rayan4444/HAX_EE_demo/ATMEGA32u4 Breakout/ATMEGA32u4_Breakout_rev1.brd

## EAGLE design ATMEGA32u4 Breakout/ATMEGA32u4_Breakout_rev1.brd (2019-09-18)

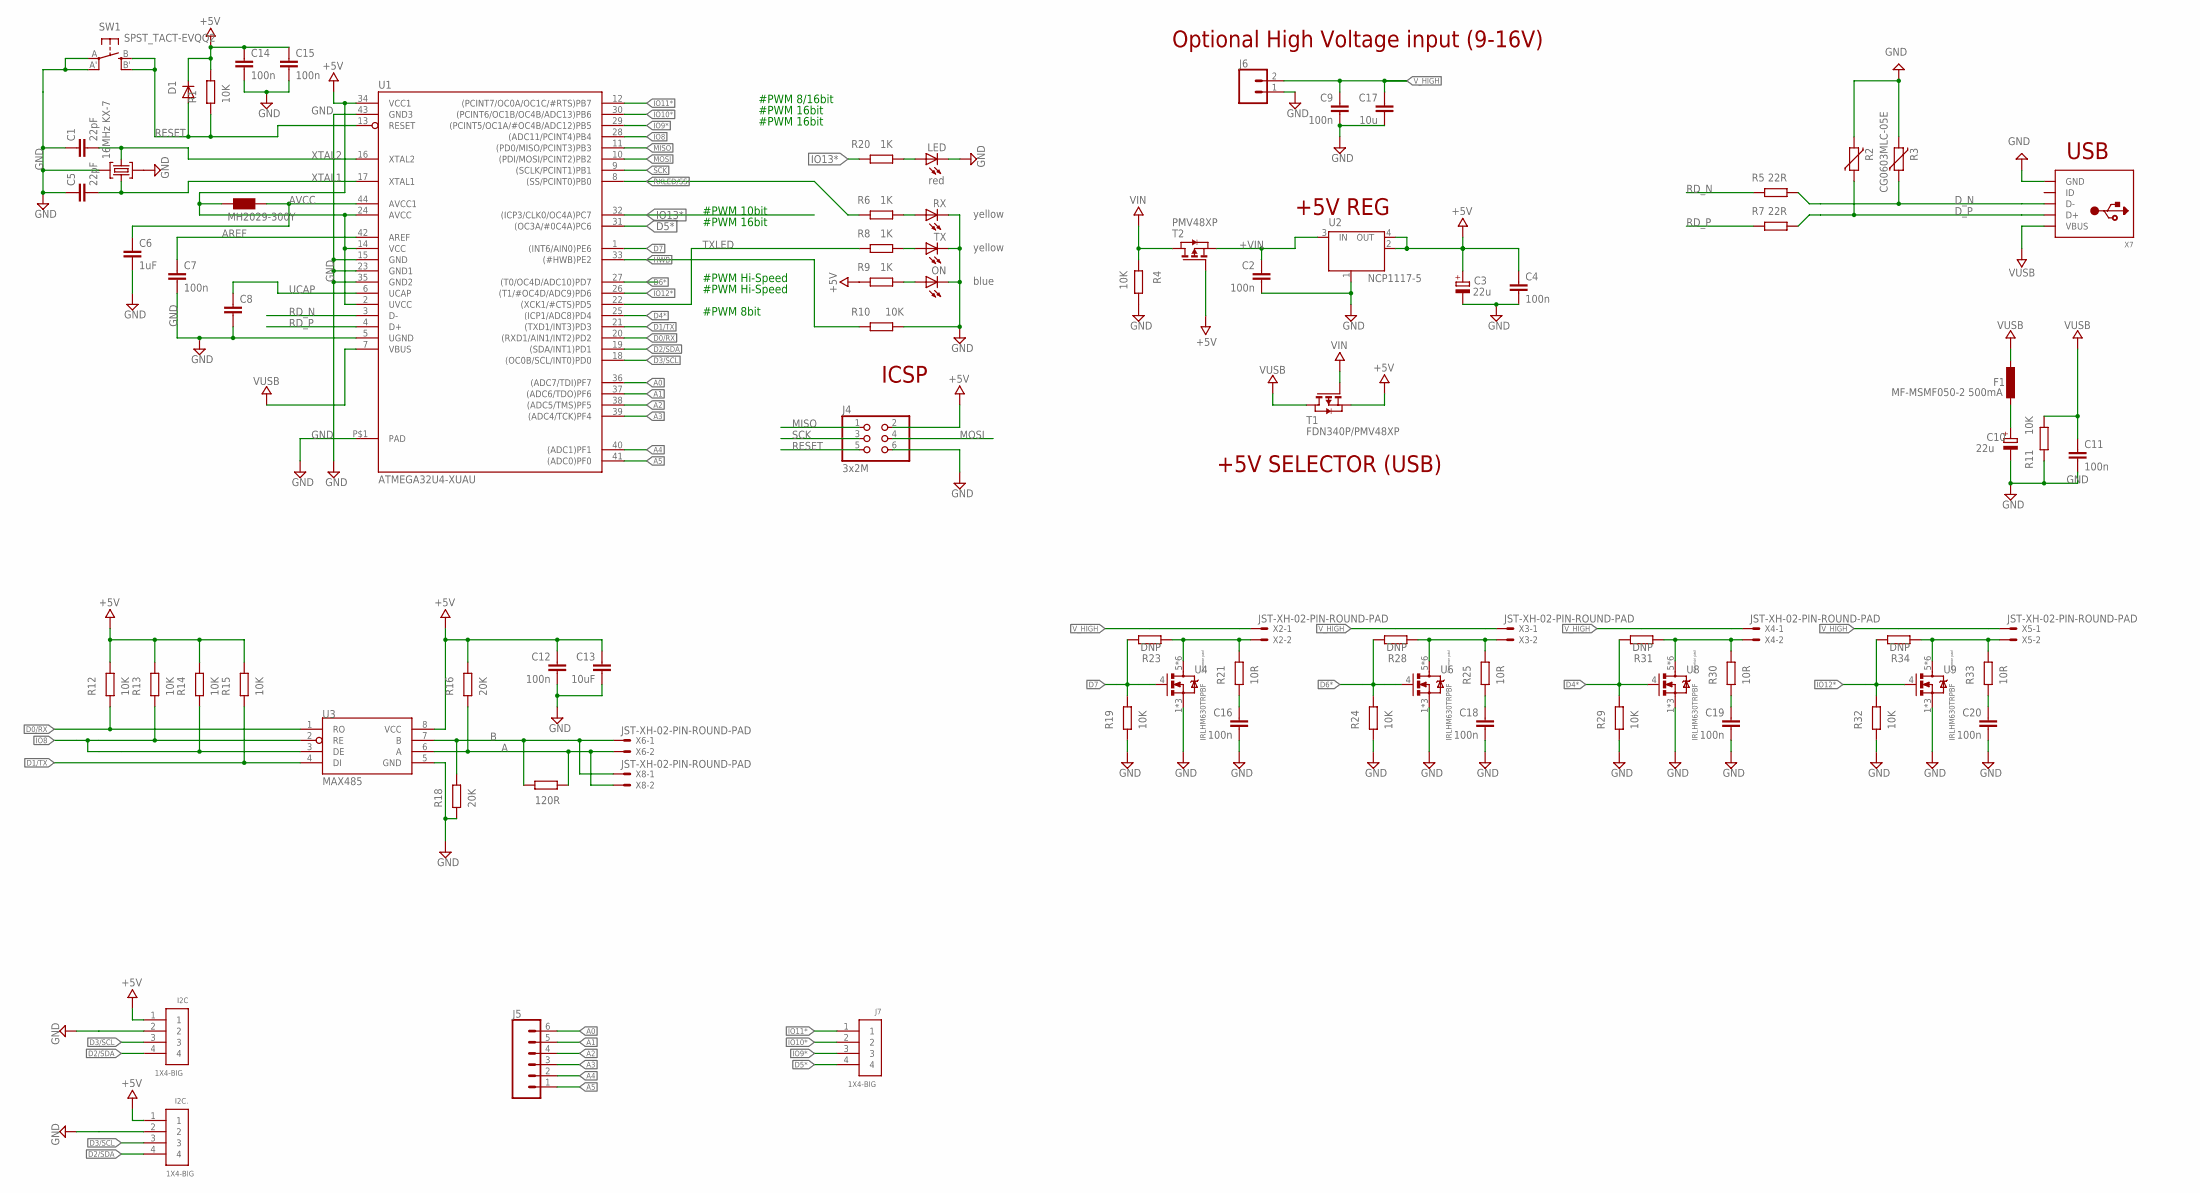
[picture p1: schematic ATMEGA32u4_Breakout_rev1.sch]

Parts:
C1, C5: 22pF; C0603-ROUND
C2, C4, C7, C11, C12, C14, C15, C16, C18, C19, C20: 100n; C0603-ROUND
C3, C10: 22u; SMC_B
C6, C8: 1uF; C0603-ROUND
C9: 100n; C1206
C13: 10uF; C0603-ROUND
C17: 10u; C1206
D1: CD1206-S01575; MINIMELF
F1: MF-MSMF050-2 500mA; L1812
I2C, I2C.: 1X4-BIG; 1X04-BIG
J4: 3x2M; 2X03
J5: CONN_06SILK_FEMALE_PTH; 1X06
J6: CONN_023.5MM; SCREWTERMINAL-3.5MM-2
J7: 1X4-BIG; 1X04-BIG
L2: MH2029-300Y; 0805
LED: red; CHIPLED_0805
ON: blue; CHIPLED_0805
R1, R4, R10, R11, R12, R13, R14, R15, R19, R24, R29, R32: 10K; R0603-ROUND
R2, R3: CG0603MLC-05E; CT/CN0603
R5, R7: 22R; R0603-ROUND
R6, R8, R9, R20: 1K; R0603-ROUND
R16, R18: 20K; R0603-ROUND
R17: 120R; R0603-ROUND
R21, R25, R30, R33: 10R; R0603-ROUND
R23, R28, R31, R34: DNP; R0603-ROUND
RX: yellow; CHIPLED_0805
SW1: SPST_TACT-EVQQ2; EVQ-Q2
T1: FDN340P/PMV48XP; SOT-23
T2: PMV48XP; SOT-23
TX: yellow; CHIPLED_0805
U1: ATMEGA32U4-XUAU; TQFP44-PAD
U2: NCP1117-5; SOT223
U3: MAX485; SO08
U4, U6, U8, U9: IRLHM630TRPBF
X1: 16MHz KX-7; CRYSTAL-3.2-2.5
X2, X3, X4, X5, X6, X8: JST-XH-02-PIN-ROUND-PAD; JST-XH-02-PACKAGE-ROUND-PAD
X7: MICROBUILDER_USB_MICRO_20329_V2; MICROBUILDER_4UCONN_20329_V2

Connections:
+5V: C3.+, C4.1, C12.1, C13.1, C14.1, C15.1, D1.C, I2C.1, I2C..1, J4.2, L2.1, R1.1, R9.1, R12.1, R13.1, R14.1, R15.1, R16.1, T1.2 (S), T2.3 (G), U1.2 (UVCC), U1.14 (VCC), U1.24 (AVCC), U1.34 (VCC1), U2.2 (OUT), U2.4 (OUT), U3.8 (VCC)
+VIN: C2.1, T2.2 (S), U2.3 (IN)
A: R16.2, R17.1, U3.6 (A), X6.2, X8.2
A0: J5.6, U1.36 ((ADC7/TDI)PF7)
A1: J5.5, U1.37 ((ADC6/TDO)PF6)
A2: J5.4, U1.38 ((ADC5/TMS)PF5)
A3: J5.3, U1.39 ((ADC4/TCK)PF4)
A4: J5.2, U1.40 ((ADC1)PF1)
A5: J5.1, U1.41 ((ADC0)PF0)
AREF: C7.1, U1.42 (AREF)
AVCC: C6.1, L2.2, U1.44 (AVCC1)
B: R17.2, R18.1, U3.7 (B), X6.1, X8.1
D0/RX: R12.2, U1.20 ((RXD1/AIN1/INT2)PD2), U3.1 (RO)
D1/TX: R15.2, U1.21 ((TXD1/INT3)PD3), U3.4 (DI)
D2/SDA: I2C.4, I2C..4, U1.19 ((SDA/INT1)PD1)
D3/SCL: I2C.3, I2C..3, U1.18 ((OC0B/SCL/INT0)PD0)
D4*: R29.1, R31.1, U1.25 ((ICP1/ADC8)PD4), U8.4
D5*: J7.4, U1.31 ((OC3A/#0C4A)PC6)
D6*: R24.1, R28.1, U1.27 ((T0/OC4D/ADC10)PD7), U6.4
D7: R19.1, R23.1, U1.1 ((INT6/AIN0)PE6), U4.4
D_N: R3.1, R5.2, X7.D-
D_P: R2.1, R7.2, X7.D+
GND: C1.1, C2.2, C3.-, C4.2, C5.1, C6.2, C7.2, C8.2, C9.2, C10.-, C11.2, C12.2, C13.2, C14.2, C15.2, C16.2, C17.2, C18.2, C19.2, C20.2, I2C.2, I2C..2, J4.6, J6.1, LED.C, ON.C, R2.2, R3.2, R4.1, R10.2, R11.1, R18.2, R19.2, R24.2, R29.2, R32.2, RX.C, SW1.A, SW1.A' (P1), TX.C, U1.5 (UGND), U1.15 (GND), U1.23 (GND1), U1.35 (GND2), U1.43 (GND3), U1.P$1 (PAD), U2.1 (GND/ADJ), U3.5 (GND), U4.1, U4.2 (1), U4.3 (1), U6.1, U6.2 (1), U6.3 (1), U8.1, U8.2 (1), U8.3 (1), U9.1, U9.2 (1), U9.3 (1), X1.2 (GND), X1.4 (GND), X7.BASE@1 (GND), X7.BASE@2 (GND), X7.GND, X7.SPRT@1 (GND), X7.SPRT@2 (GND), X7.SPRT@3 (GND), X7.SPRT@4 (GND)
HWB: R10.1, U1.33 ((#HWB)PE2)
IO8: R13.2, R14.2, U1.28 ((ADC11/PCINT4)PB4), U3.2 (RE), U3.3 (DE)
IO9*: J7.3, U1.29 ((PCINT5/OC1A/#OC4B/ADC12)PB5)
IO10*: J7.2, U1.30 ((PCINT6/OC1B/OC4B/ADC13)PB6)
IO11*: J7.1, U1.12 ((PCINT7/OC0A/OC1C/#RTS)PB7)
IO12*: R32.1, R34.1, U1.26 ((T1/#OC4D/ADC9)PD6), U9.4
IO13*: R20.1, U1.32 ((ICP3/CLK0/OC4A)PC7)
MISO: J4.1, U1.11 ((PD0/MISO/PCINT3)PB3)
MOSI: J4.4, U1.10 ((PDI/MOSI/PCINT2)PB2)
unnamed: R6.2, RX.A
unnamed: ON.A, R9.2
unnamed: R8.2, TX.A
unnamed: C16.1, R21.2
unnamed: LED.A, R20.2
unnamed: R21.1, R23.2, U4.5, U4.6 (5), U4.7 (5), U4.8 (5), U4.9 (5), U4.10 (5), X2.2
unnamed: C18.1, R25.2
unnamed: R25.1, R28.2, U6.5, U6.6 (5), U6.7 (5), U6.8 (5), U6.9 (5), U6.10 (5), X3.2
unnamed: C19.1, R30.2
unnamed: R30.1, R31.2, U8.5, U8.6 (5), U8.7 (5), U8.8 (5), U8.9 (5), U8.10 (5), X4.2
unnamed: C20.1, R33.2
unnamed: R33.1, R34.2, U9.5, U9.6 (5), U9.7 (5), U9.8 (5), U9.9 (5), U9.10 (5), X5.2
RD_N: R5.1, U1.3 (D-)
RD_P: R7.1, U1.4 (D+)
RESET: D1.A, J4.5, R1.2, SW1.B (S), SW1.B' (S1), U1.13 (RESET)
RXLED/SS: R6.1, U1.8 ((SS/PCINT0)PB0)
SCK: J4.3, U1.9 ((SCLK/PCINT1)PB1)
TXLED: R8.1, U1.22 ((XCK1/#CTS)PD5)
UCAP: C8.1, U1.6 (UCAP)
VIN: R4.2, T1.3 (G), T2.1 (D)
VUSB: C11.1, F1.2, R11.2, T1.1 (D), U1.7 (VBUS), X7.VBUS
VUSBD: C10.+, F1.1
V_HIGH: C9.1, C17.1, J6.2, X2.1, X3.1, X4.1, X5.1
XTAL1: C5.2, U1.17 (XTAL1), X1.3 (C2)
XTAL2: C1.2, U1.16 (XTAL2), X1.1 (C1)

Notes on the sheet:
+5V REG
ICSP
USB
+5V SELECTOR (USB)
#PWM 8bit
#PWM Hi-Speed
#PWM 16bit
#PWM 10bit
#PWM 8/16bit
Optional High Voltage input (9-16V)

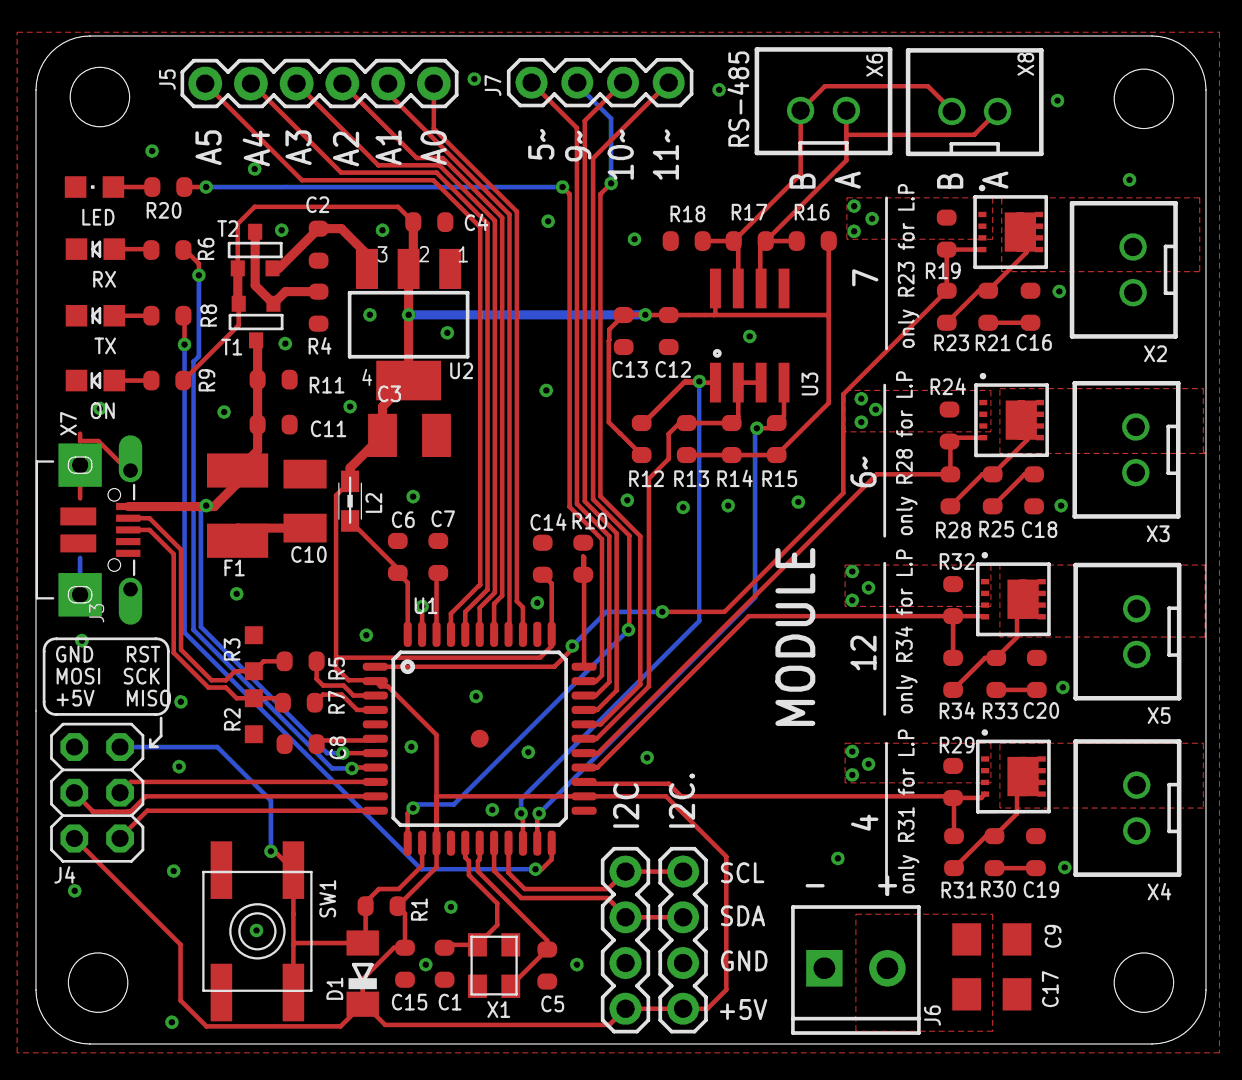
[picture p2: board ATMEGA32u4_Breakout_rev1.brd from above]

Board: 2 copper layers, 65.0 x 56.0 mm, 82 parts (0 on the bottom side), 57 nets.
